antmicro/raspberry-pi-cm4-csi-adapter/rpi-cm4-csi-adapter.kicad_pcb

## KiCad design rpi-cm4-csi-adapter.kicad_pcb (2022-08-09)

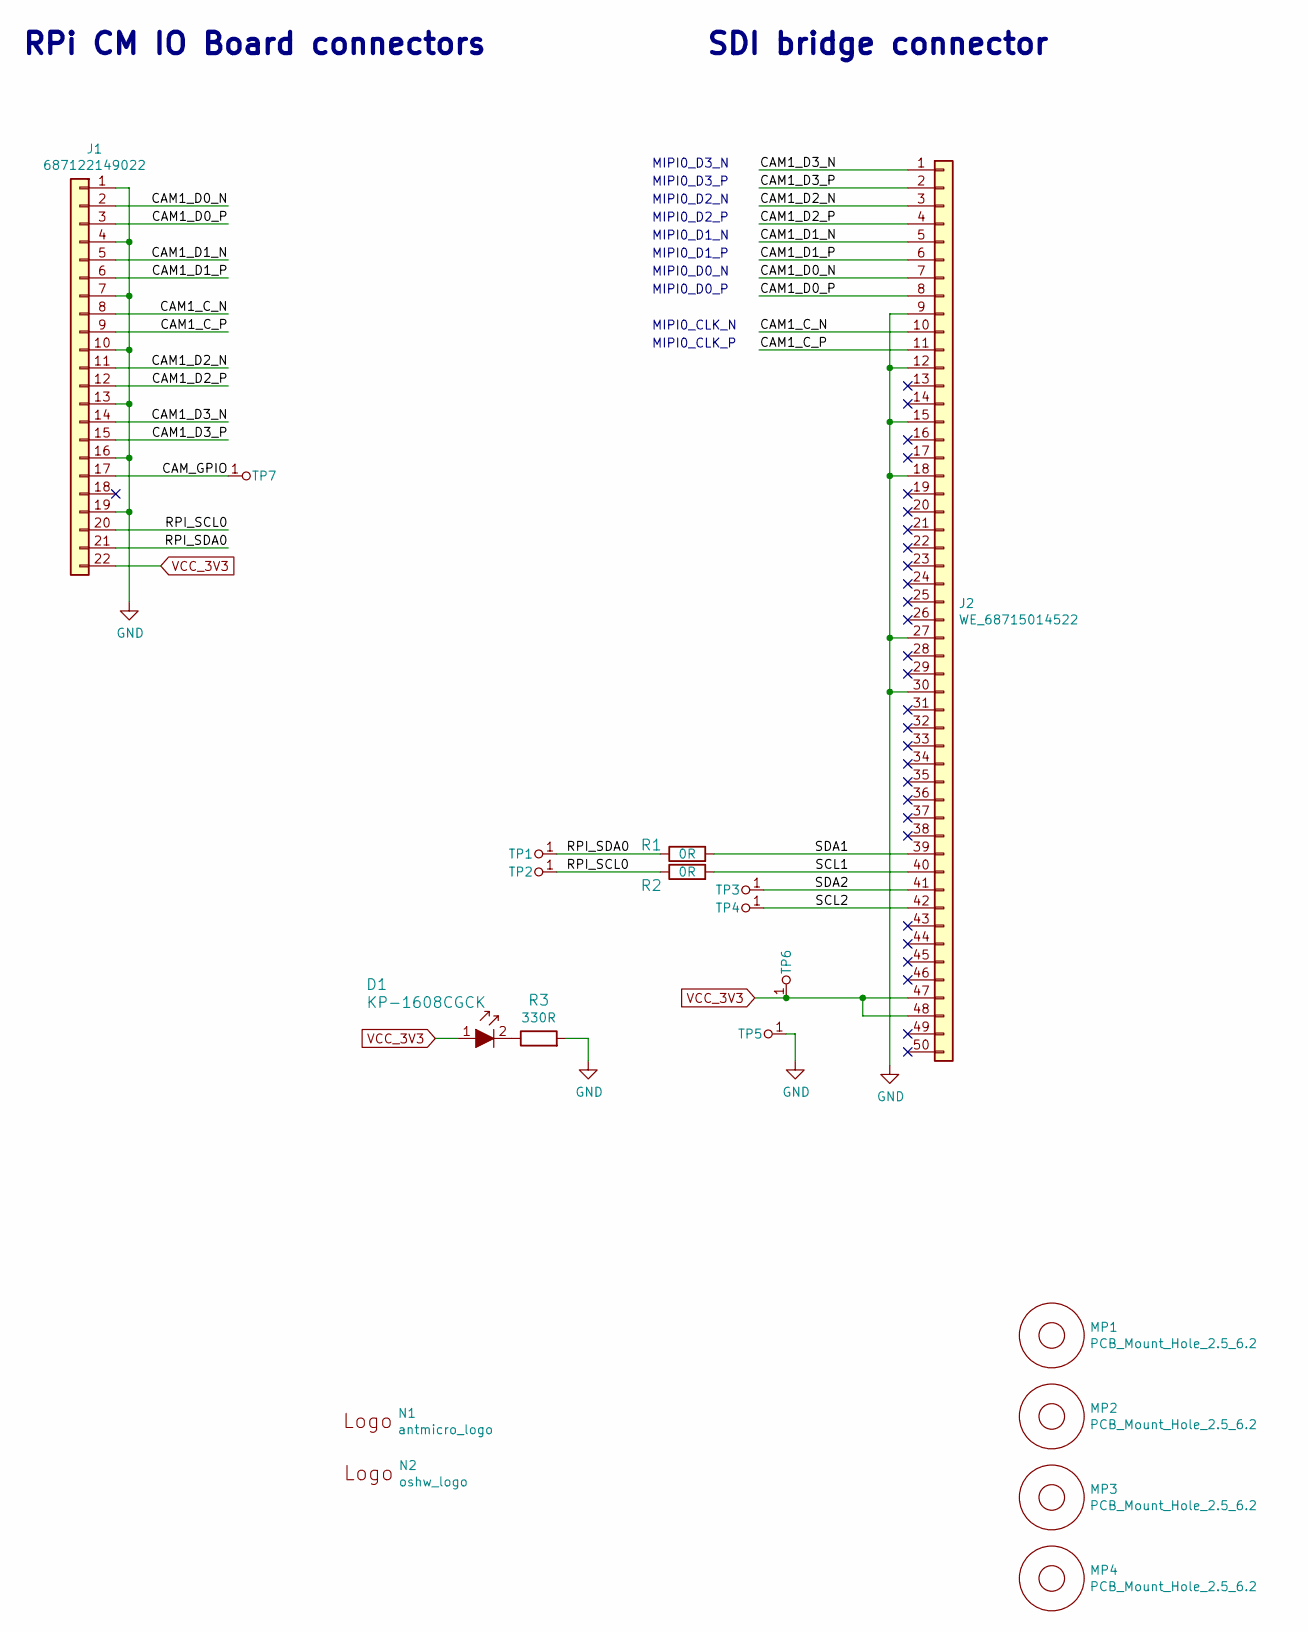
[picture p2: schematic rpi-cm4-csi-adapter.sch, RPi CM4 CSI adapter]

Parts:
D1: KP-1608CGCK; LED_0603; MPN KP-1608CGCK
J1: 687122149022; MPN 687122149022
J2: WE_68715014522; MPN 68715014522
MP1, MP2, MP3, MP4: PCB_Mount_Hole_2.5_6.2; Mount-hole-M2.5
N1: antmicro_logo; antmicro-logo_scaled_12mm
N2: oshw_logo; oshw-logo
R1, R2: R_0R_0402; 0402-res; MPN ERJ2GE0R00X
R3: R_330R_0402; 0402-res; MPN MCMR04X3300FTL
TP1, TP2, TP3, TP4, TP5, TP6, TP7: TP; TP-R-1.5

Connections:
/CAM1_C_N: J1.8, J2.10
/CAM1_C_P: J1.9, J2.11
/CAM1_D0_N: J1.2, J2.7
/CAM1_D0_P: J1.3, J2.8
/CAM1_D1_N: J1.5, J2.5
/CAM1_D1_P: J1.6, J2.6
/CAM1_D2_N: J1.11, J2.3
/CAM1_D2_P: J1.12, J2.4
/CAM1_D3_N: J1.14, J2.1
/CAM1_D3_P: J1.15, J2.2
/CAM_GPIO: J1.17, TP7.1
/RPI_SCL0: J1.20, R2.1, TP2.1
/RPI_SDA0: J1.21, R1.1, TP1.1
/SCL1: J2.40, R2.2
/SCL2: J2.42, TP4.1
/SDA1: J2.39, R1.2
/SDA2: J2.41, TP3.1
GND: J1.1, J1.4, J1.7, J1.10, J1.13, J1.16, J1.19, J2.9, J2.12, J2.15, J2.18, J2.27, J2.30, R3.2, TP5.1
unnamed: D1.2, R3.1
VCC_3V3: D1.1, J1.22, J2.47, J2.48, TP6.1

Notes on the sheet:
SDI bridge connector
RPi CM IO Board connectors
MIPI0_D1_N
MIPI0_D1_P
MIPI0_D0_N
MIPI0_D0_P
MIPI0_CLK_N
MIPI0_CLK_P
MIPI0_D2_P
MIPI0_D2_N
MIPI0_D3_P
MIPI0_D3_N

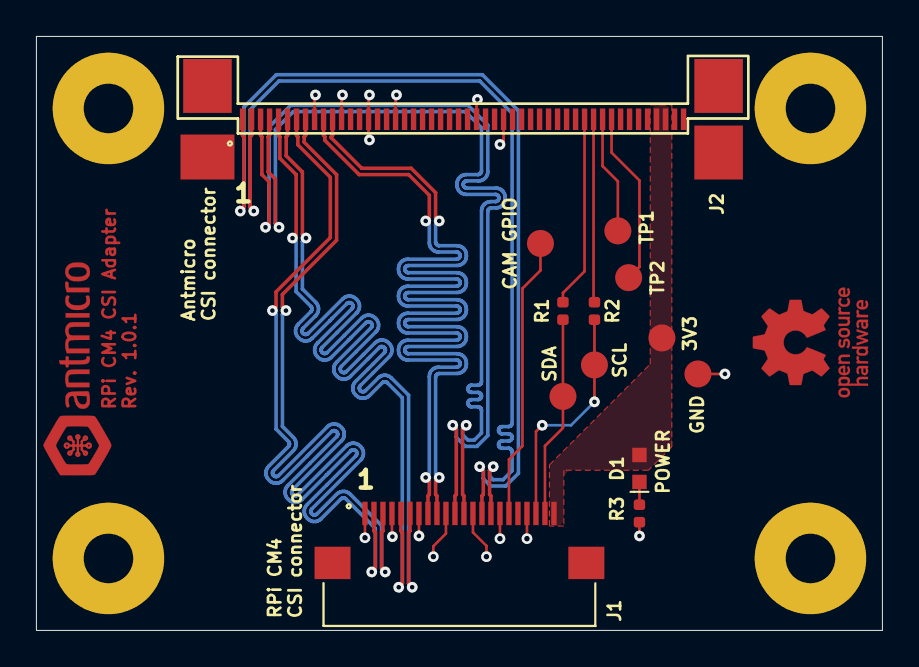
[picture p3: board rpi-cm4-csi-adapter.kicad_pcb from above]

Board: 4 copper layers, 47.0 x 33.0 mm, 19 parts (0 on the bottom side), 20 nets.
