antmicro/raspberry-pi-cm4-csi-adapter/(commit log)

2022-08-09 Initial commit.
    [rpi-cm4-csi-adapter.kicad_pcb, rpi-cm4-csi-adapter.sch]
2022-08-09 Generate local libraries
    [rpi-cm4-csi-adapter.kicad_pcb, rpi-cm4-csi-adapter.sch]
2022-08-09 Make 687122149022 a SMT component
    [rpi-cm4-csi-adapter.kicad_pcb]
2022-08-09 Swap I2C lines - bump revision to 1.0.1
    [rpi-cm4-csi-adapter.kicad_pcb, rpi-cm4-csi-adapter.sch]
2022-08-09 Add KiCad 6.0 project
